NPoole/PSA_Oxygen_Concentrator/README.md

# PSA_Oxygen_Concentrator
An Oxikit-style Pressure Swing Adsorption Oxygen concentrator

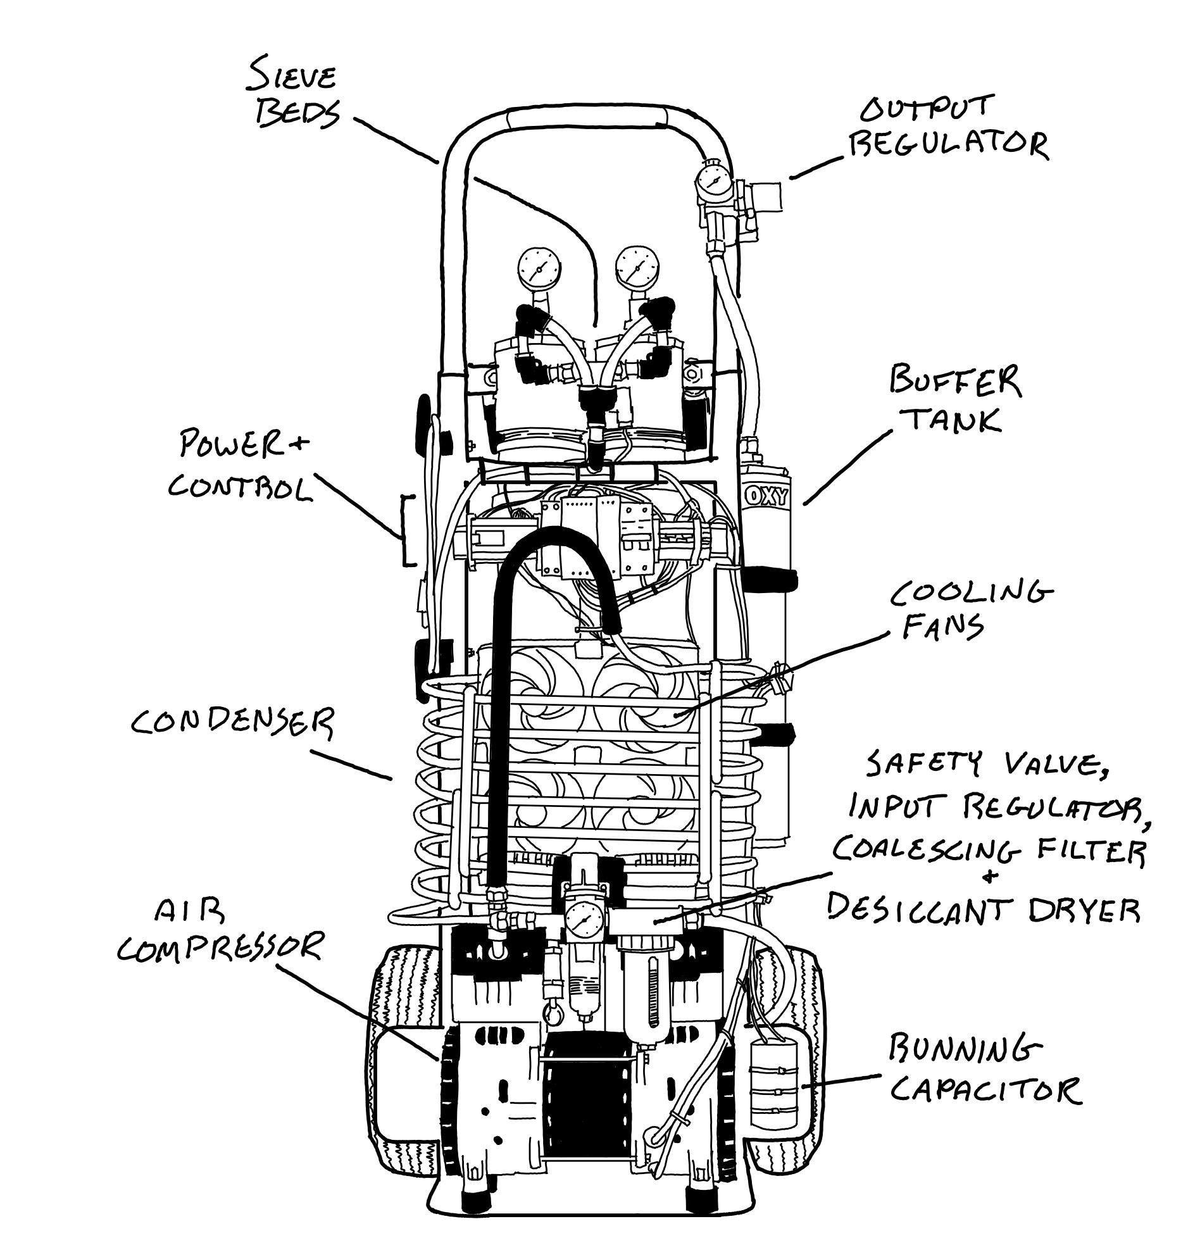
[picture p1: Photos/Illustration.png]
Complete System Illustration
