NPoole/PSA_Oxygen_Concentrator/Photos/Complete_Front.jpg

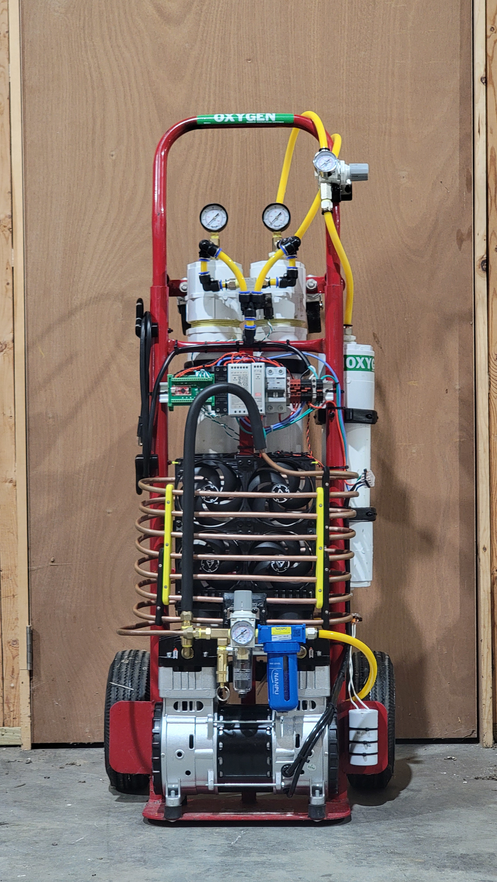
Photos/Complete_Front.jpg
