NPoole/PSA_Oxygen_Concentrator/Photos/Complete_Rear.jpg

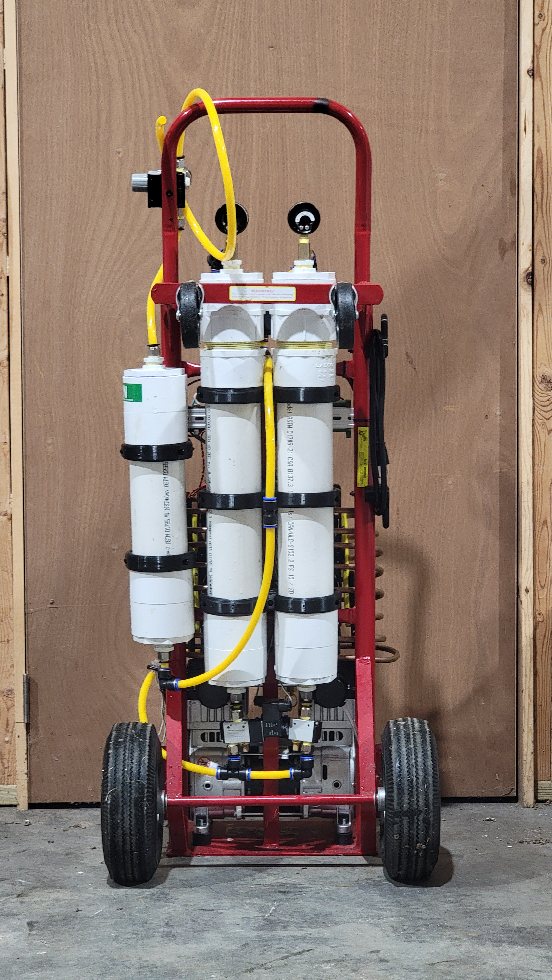
Photos/Complete_Rear.jpg
