NPoole/PSA_Oxygen_Concentrator/Photos/Complete_Side.jpg

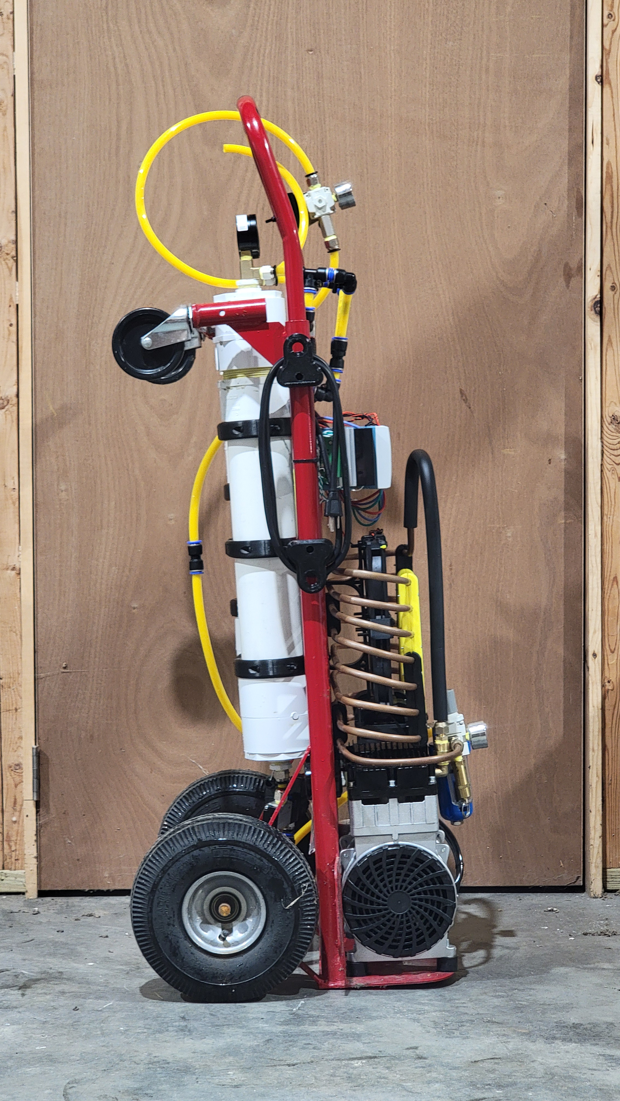
Photos/Complete_Side.jpg
