NPoole/PSA_Oxygen_Concentrator/CAD/STEP/Input Regulator Mount.step

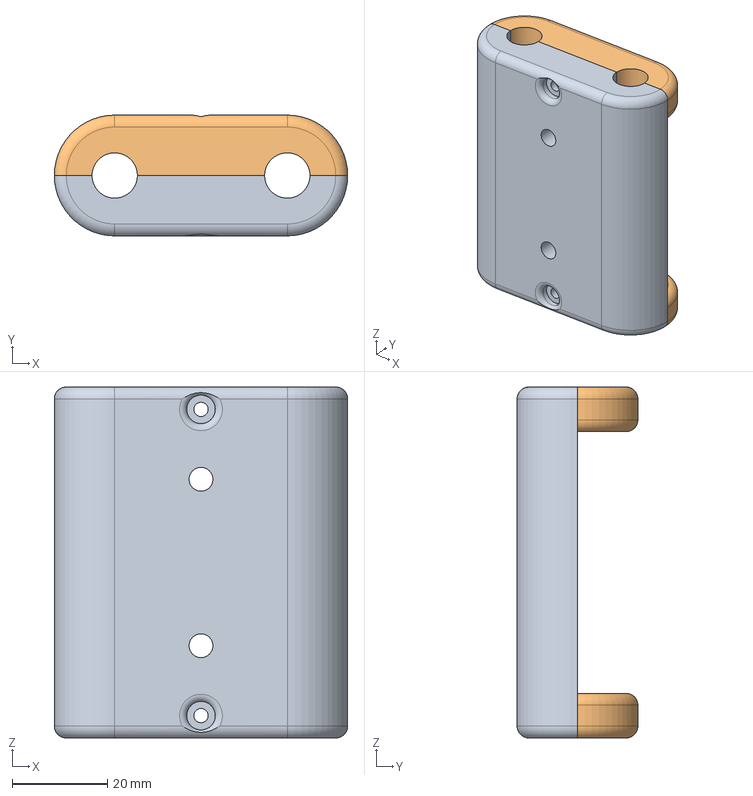
[picture p5: CAD file, 2024-06-01]
CAD/STEP/Input Regulator Mount.step
61.7 x 25.4 x 73.8 mm
