NPoole/PSA_Oxygen_Concentrator/CAD/STL/Hourmeter Mount.stl

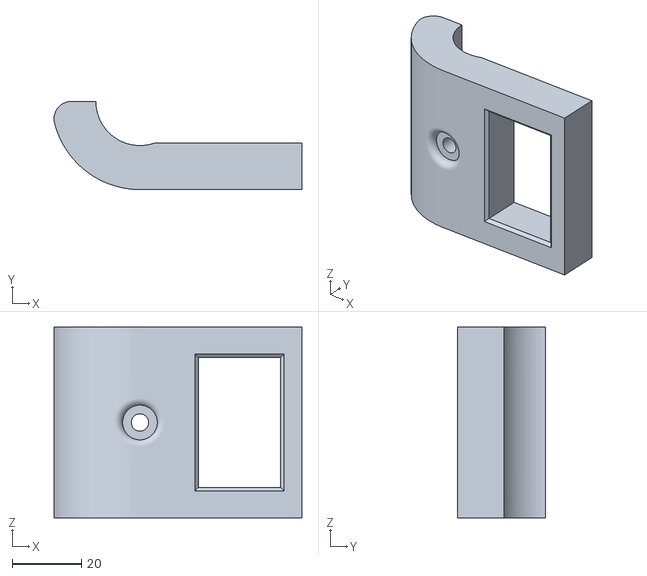
[picture p6: CAD file, 2024-06-11]
CAD/STL/Hourmeter Mount.stl
71.5 x 25.4 x 55.0
