NPoole/PSA_Oxygen_Concentrator/CAD/STEP/Coil Support Small.step

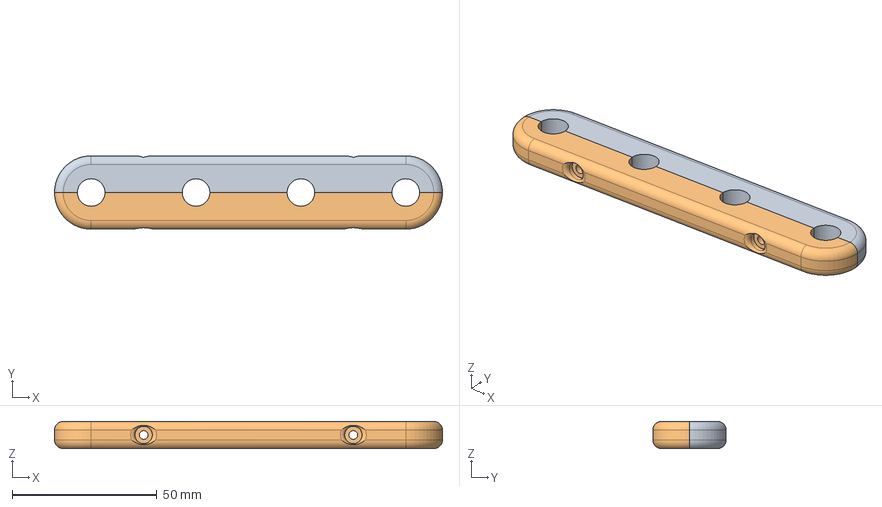
[picture p7: CAD file, 2024-06-01]
CAD/STEP/Coil Support Small.step
134.3 x 25.4 x 9.40 mm
