NPoole/PSA_Oxygen_Concentrator/CAD/STL/Cooling Fan Connector A.stl

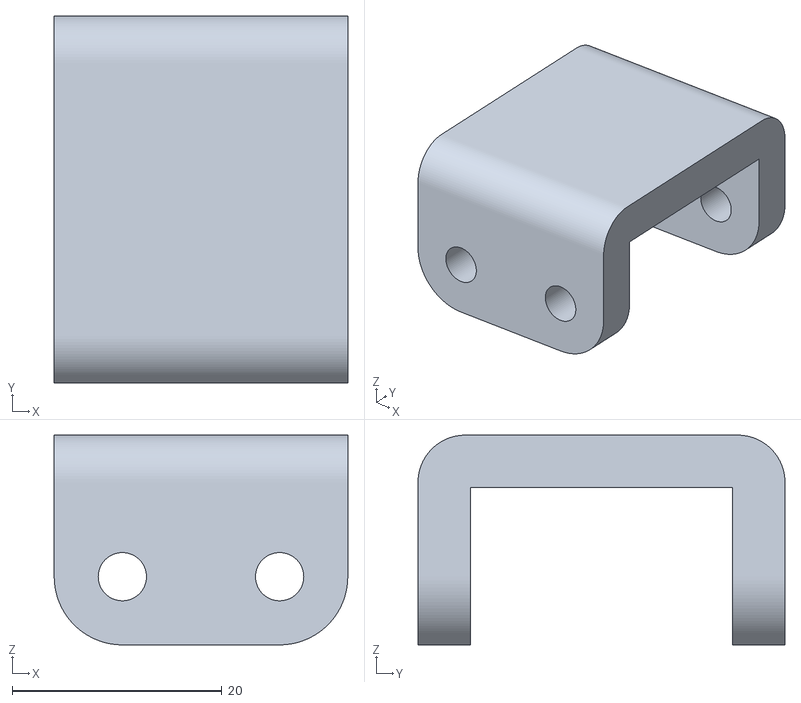
[picture p8: CAD file, 2024-06-01]
CAD/STL/Cooling Fan Connector A.stl
28.0 x 35.0 x 20.0
