NPoole/PSA_Oxygen_Concentrator/CAD/STEP/1_6mm orifice.step

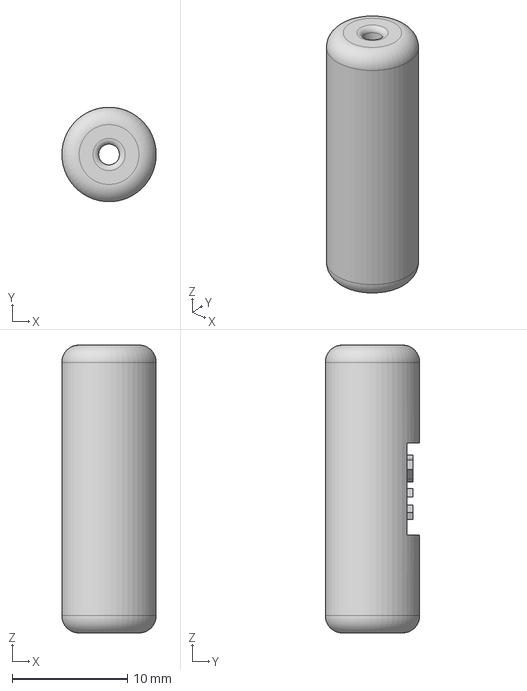
[picture p9: CAD file, 2024-06-01]
CAD/STEP/1_6mm orifice.step
8.19 x 8.20 x 25.0 mm
