NPoole/PSA_Oxygen_Concentrator/CAD/STL/Sieve Bed Piston.stl

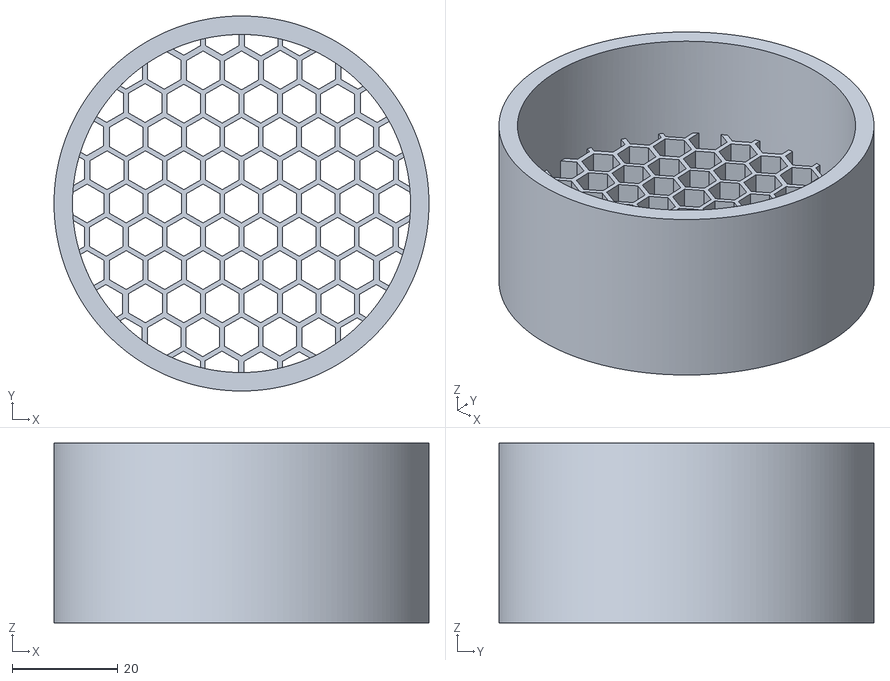
[picture p10: CAD file, 2024-06-01]
CAD/STL/Sieve Bed Piston.stl
71.0 x 71.0 x 34.0
