NPoole/PSA_Oxygen_Concentrator/CAD/STEP/Coil Support Large.step

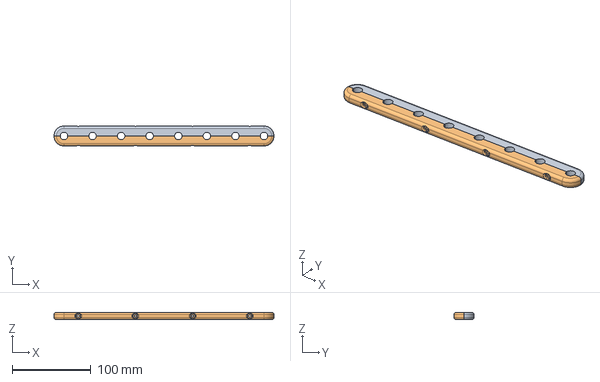
[picture p11: CAD file, 2024-06-01]
CAD/STEP/Coil Support Large.step
279.4 x 25.4 x 9.40 mm
