NPoole/PSA_Oxygen_Concentrator/CAD/STL/Cooling Fan Connector C.stl

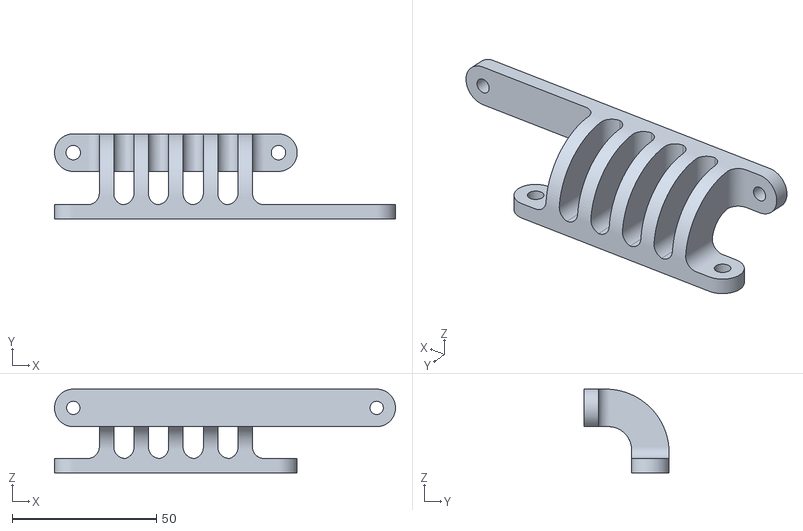
[picture p12: CAD file, 2024-06-01]
CAD/STL/Cooling Fan Connector C.stl
118.0 x 29.5 x 29.0
