NPoole/PSA_Oxygen_Concentrator/CAD/STEP/DIN Rail Mount.step

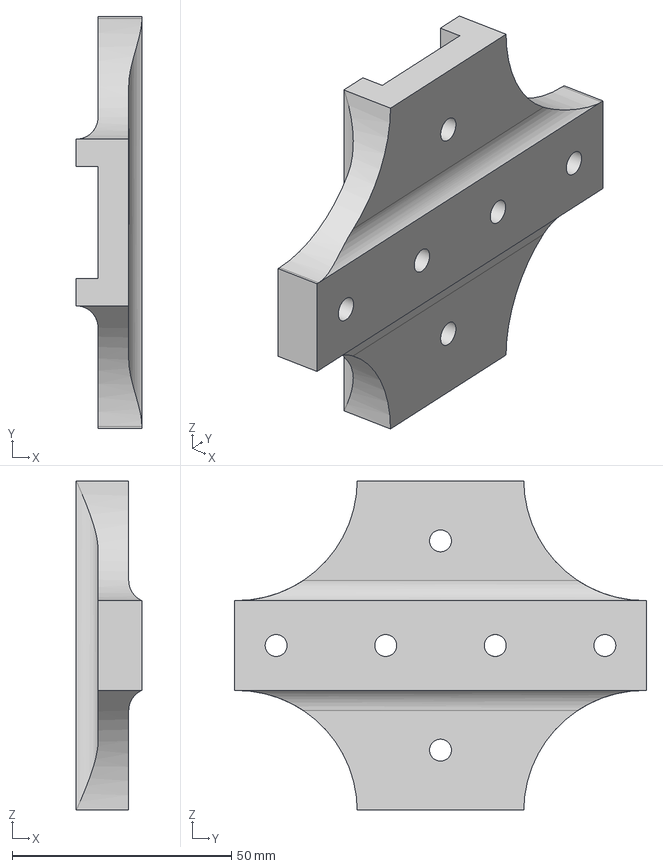
[picture p13: CAD file, 2024-06-01]
CAD/STEP/DIN Rail Mount.step
15.0 x 94.0 x 75.0 mm
