NPoole/PSA_Oxygen_Concentrator/CAD/STL/Input Regulator Mount Part B.stl

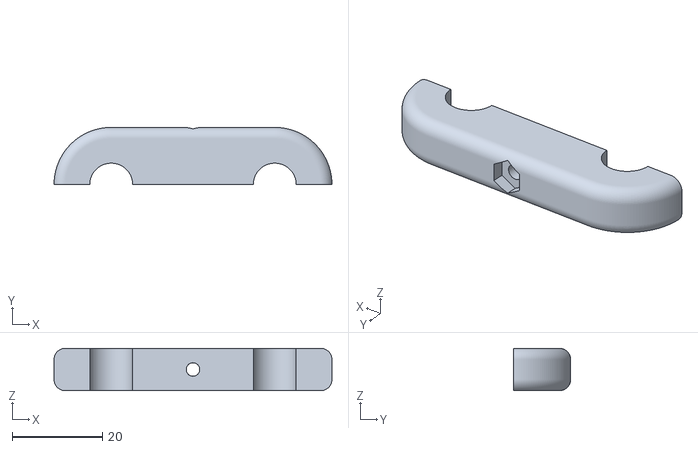
[picture p14: CAD file, 2024-06-01]
CAD/STL/Input Regulator Mount Part B.stl
61.7 x 12.7 x 9.40
