NPoole/PSA_Oxygen_Concentrator/CAD/STEP/Coil Mount.step

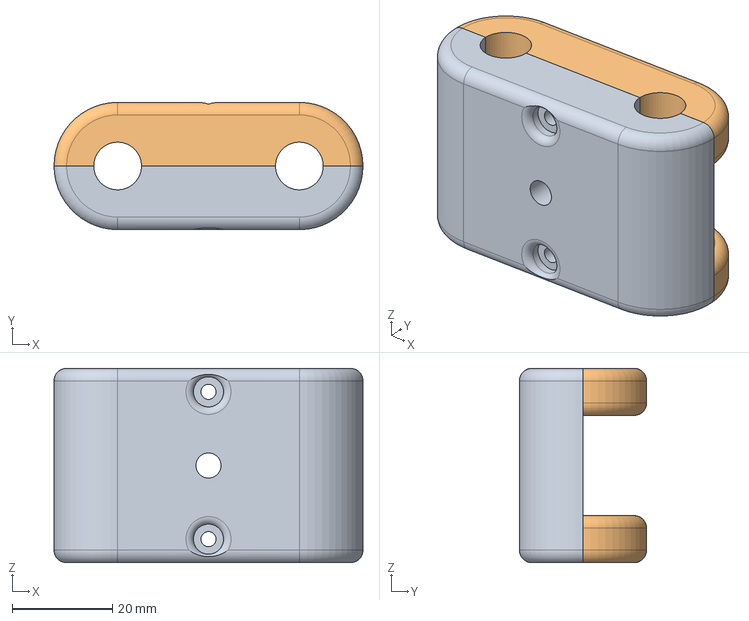
[picture p15: CAD file, 2024-06-01]
CAD/STEP/Coil Mount.step
61.7 x 25.4 x 38.8 mm
