NPoole/PSA_Oxygen_Concentrator/CAD/STEP/Output Regulator Mount.step

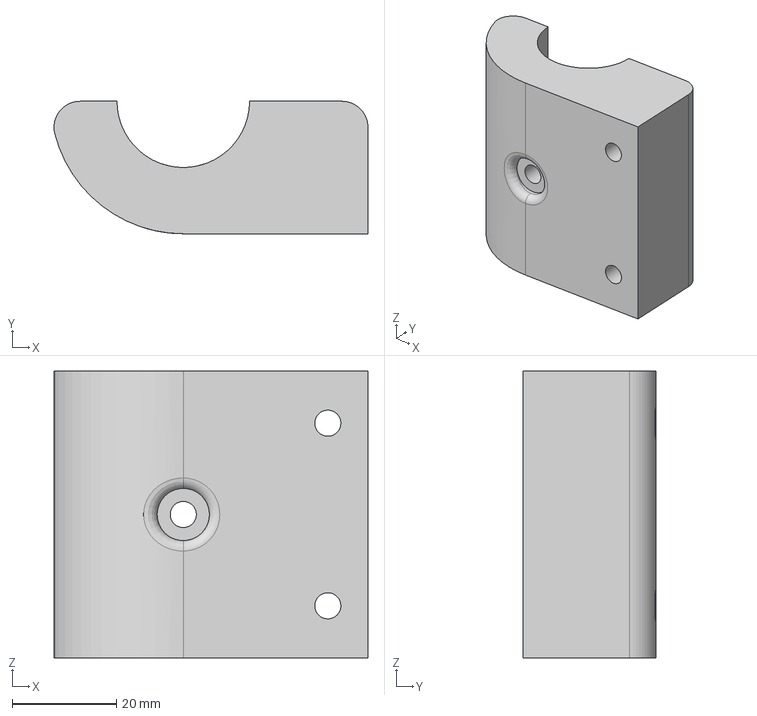
[picture p16: CAD file, 2024-06-01]
CAD/STEP/Output Regulator Mount.step
60.2 x 25.4 x 55.0 mm
