NPoole/PSA_Oxygen_Concentrator/CAD/STL/Coil Support Part B (SML).stl

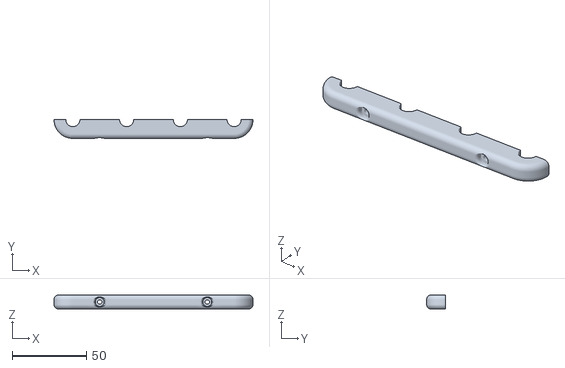
[picture p17: CAD file, 2024-06-01]
CAD/STL/Coil Support Part B (SML).stl
134.3 x 12.7 x 9.40
