NPoole/PSA_Oxygen_Concentrator/CAD/STEP/Sieve Bed Parts.step

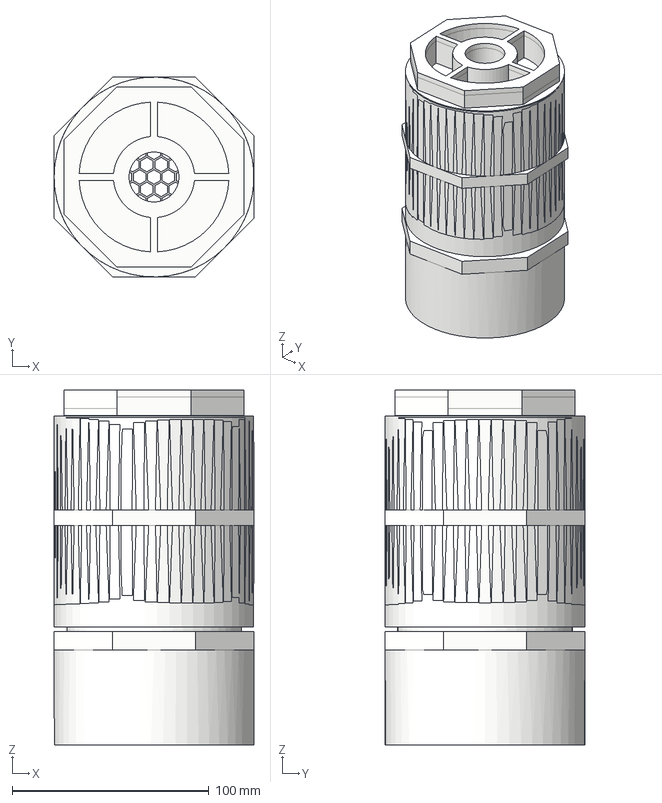
[picture p18: CAD file, 2024-06-01]
CAD/STEP/Sieve Bed Parts.step
101.6 x 101.6 x 180.5 mm
