NPoole/PSA_Oxygen_Concentrator/CAD/STL/Sieve Mount Part B.stl

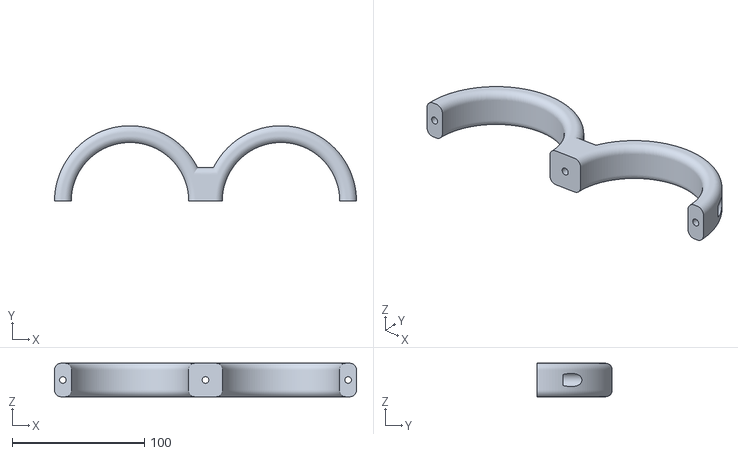
[picture p19: CAD file, 2024-06-01]
CAD/STL/Sieve Mount Part B.stl
228.6 x 57.1 x 25.4
