NPoole/PSA_Oxygen_Concentrator/CAD/STEP/Sieve Mount.step

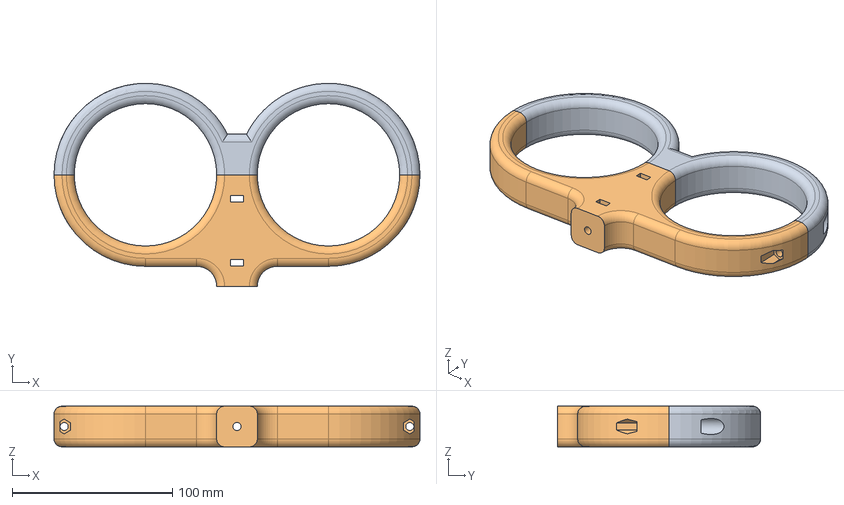
[picture p20: CAD file, 2024-06-01]
CAD/STEP/Sieve Mount.step
228.6 x 127.0 x 25.4 mm
