NPoole/PSA_Oxygen_Concentrator/CAD/STL/Cooling Fan Connector B.stl

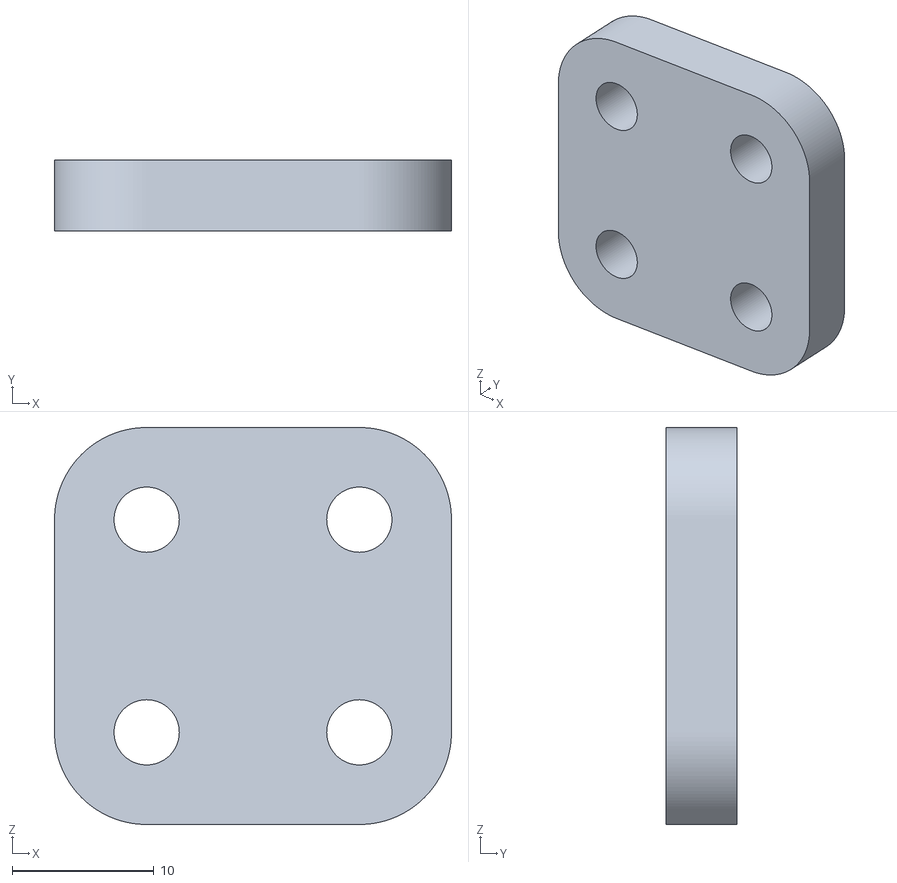
[picture p21: CAD file, 2024-06-01]
CAD/STL/Cooling Fan Connector B.stl
28.0 x 5.00 x 28.0
