NPoole/PSA_Oxygen_Concentrator/CAD/STEP/Buffer Mount.step

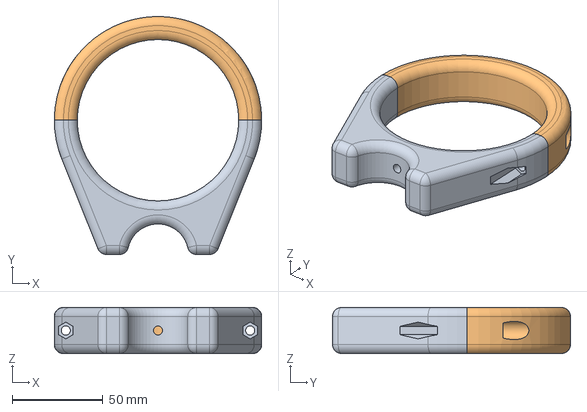
[picture p22: CAD file, 2024-06-01]
CAD/STEP/Buffer Mount.step
114.3 x 131.1 x 25.4 mm
