NPoole/PSA_Oxygen_Concentrator/CAD/STL/Coil Support Part B (LRG).stl

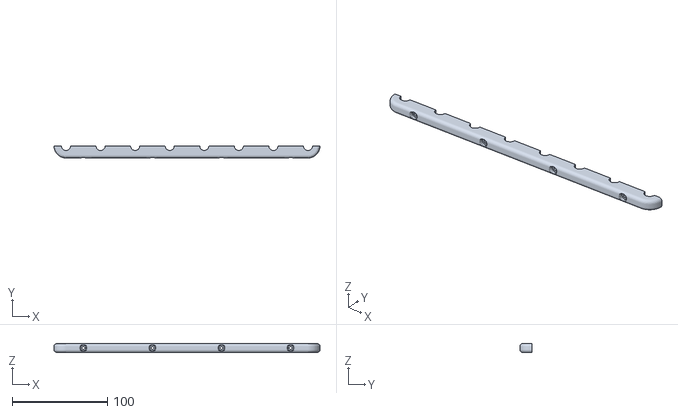
[picture p23: CAD file, 2024-06-01]
CAD/STL/Coil Support Part B (LRG).stl
279.4 x 12.7 x 9.40
