NPoole/PSA_Oxygen_Concentrator/CAD/STEP/Cord Keeper.step

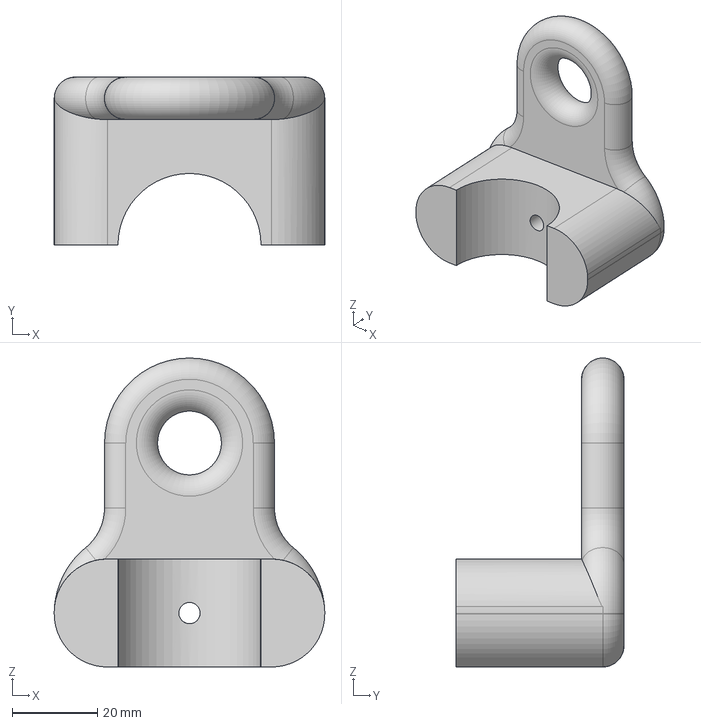
[picture p24: CAD file, 2024-06-01]
CAD/STEP/Cord Keeper.step
63.7 x 39.5 x 72.7 mm
