NPoole/PSA_Oxygen_Concentrator/CAD/STL/Buffer Mount Part A.stl

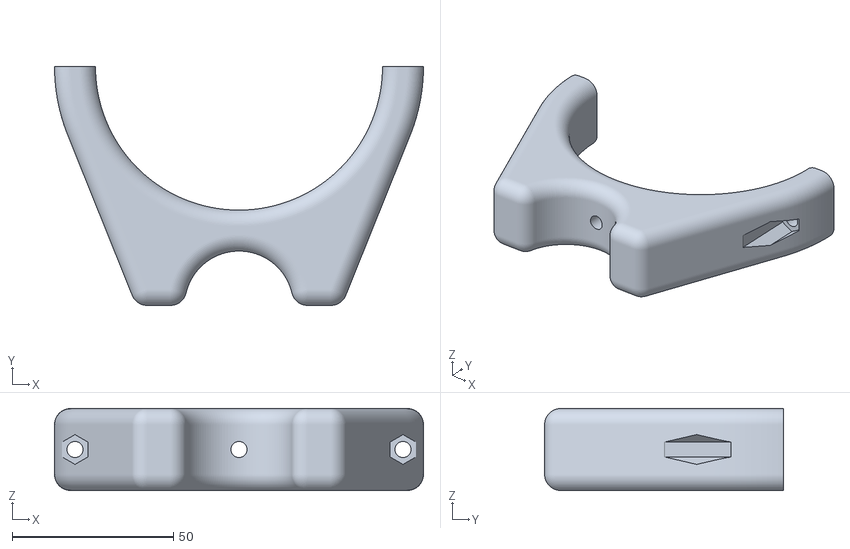
[picture p25: CAD file, 2024-06-01]
CAD/STL/Buffer Mount Part A.stl
114.3 x 74.0 x 25.4
