NPoole/PSA_Oxygen_Concentrator/CAD/STL/Input Regulator Mount Part A.stl

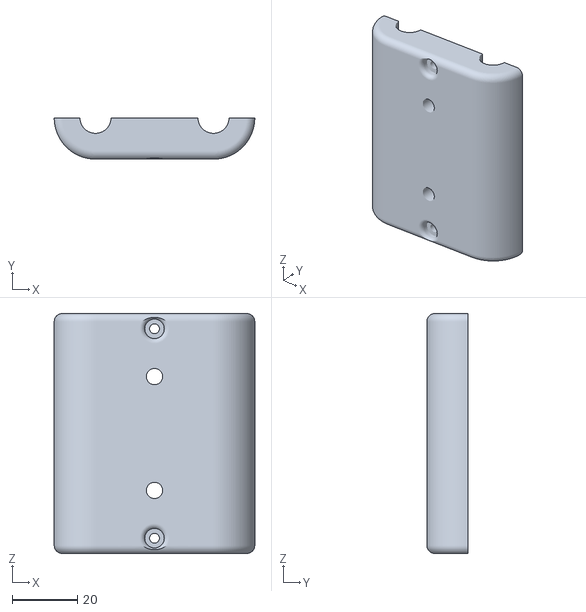
[picture p26: CAD file, 2024-06-01]
CAD/STL/Input Regulator Mount Part A.stl
61.7 x 12.7 x 73.8
