NPoole/PSA_Oxygen_Concentrator/CAD/STL/Sieve Bed Mesh Retainer.stl

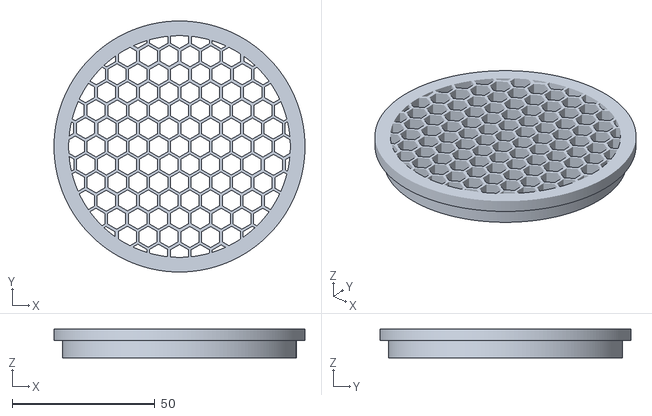
[picture p27: CAD file, 2024-06-01]
CAD/STL/Sieve Bed Mesh Retainer.stl
88.0 x 88.0 x 10.0
