NPoole/PSA_Oxygen_Concentrator/CAD/STL/Sieve Bed Spring Seat.stl

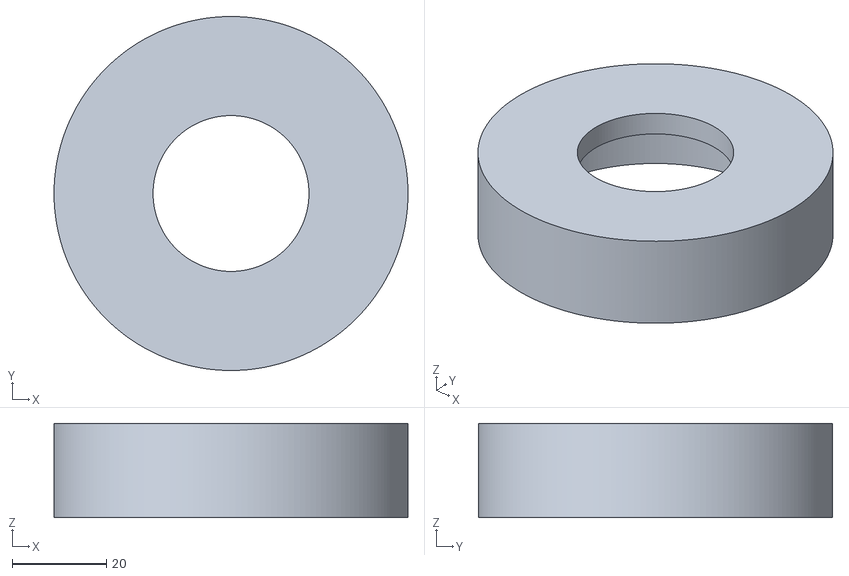
[picture p28: CAD file, 2024-06-01]
CAD/STL/Sieve Bed Spring Seat.stl
75.0 x 75.0 x 20.0
