NPoole/PSA_Oxygen_Concentrator/CAD/STL/Sieve Mount Part A.stl

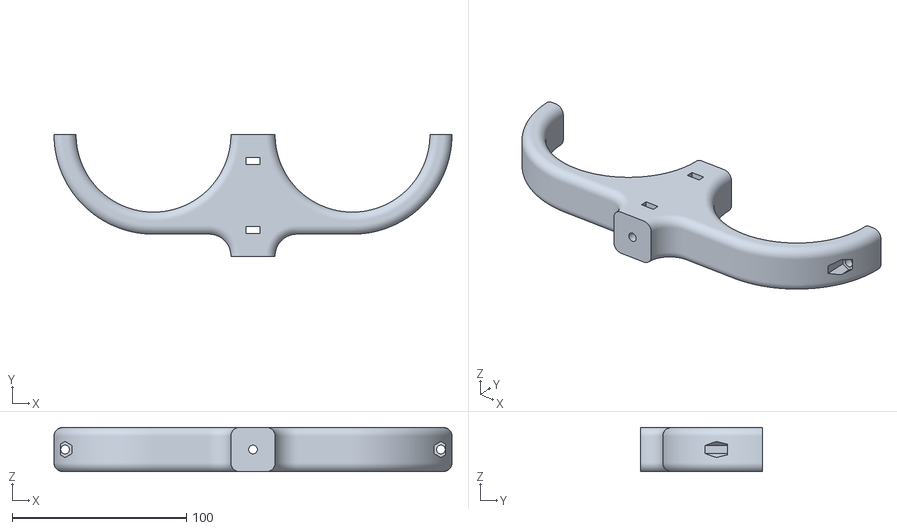
[picture p29: CAD file, 2024-06-01]
CAD/STL/Sieve Mount Part A.stl
228.6 x 69.8 x 25.4
