NPoole/PSA_Oxygen_Concentrator/CAD/STL/Cooling Fan Mount.stl

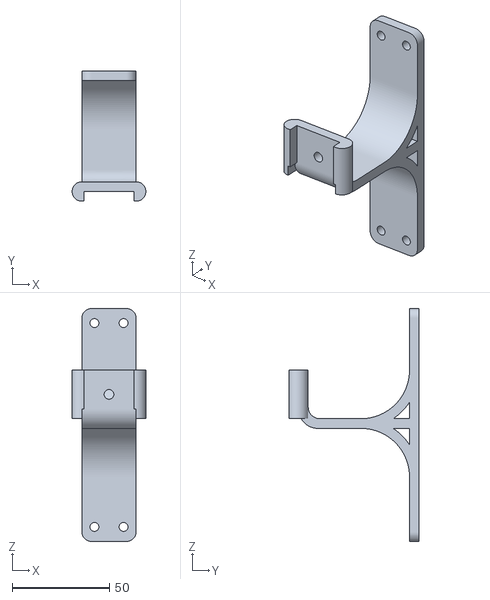
[picture p30: CAD file, 2024-06-01]
CAD/STL/Cooling Fan Mount.stl
38.0 x 67.2 x 120.0
