NPoole/PSA_Oxygen_Concentrator/CAD/STL/Buffer Mount Part B.stl

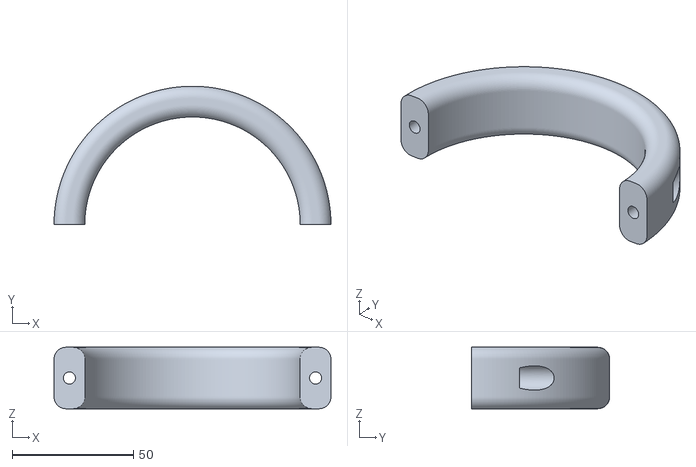
[picture p31: CAD file, 2024-06-01]
CAD/STL/Buffer Mount Part B.stl
114.3 x 57.2 x 25.4
