NPoole/PSA_Oxygen_Concentrator/CAD/STL/Coil Mount Part A.stl

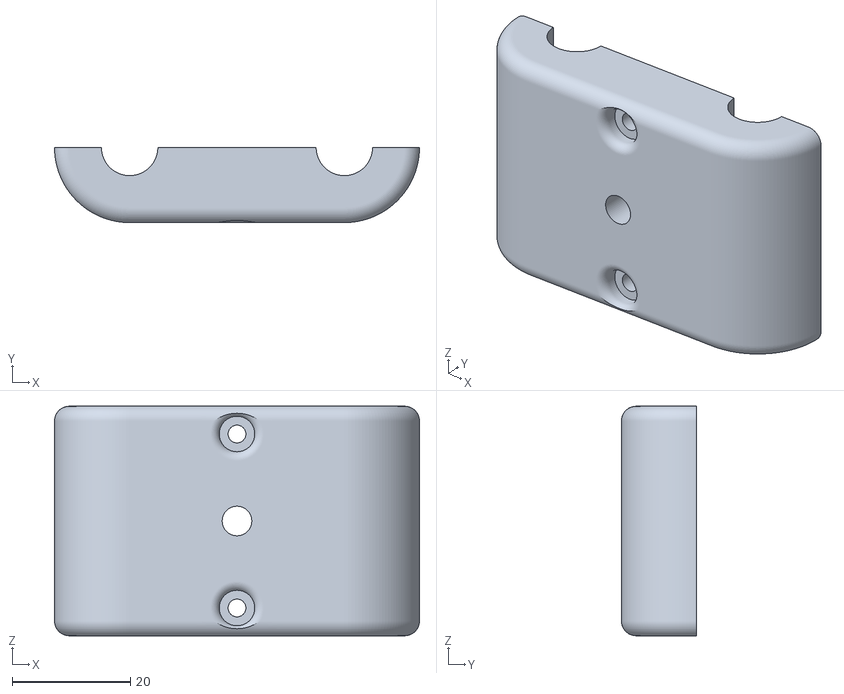
[picture p32: CAD file, 2024-06-01]
CAD/STL/Coil Mount Part A.stl
61.7 x 12.7 x 38.8
