NPoole/PSA_Oxygen_Concentrator/(list of files, cad)

Other CAD files:
CAD/STL/Cooling Fan Connector D.stl
CAD/STL/Coil Support Part A (SML).stl
CAD/STL/Coil Support Part A (LRG).stl
CAD/STL/1_6mm orifice.stl
CAD/STL/Cord Keeper.stl
CAD/STL/DIN Rail Mount.stl
CAD/STL/Output Regulator Mount.stl
