NPoole/PSA_Oxygen_Concentrator/Photos/Cooling Assembly.jpg

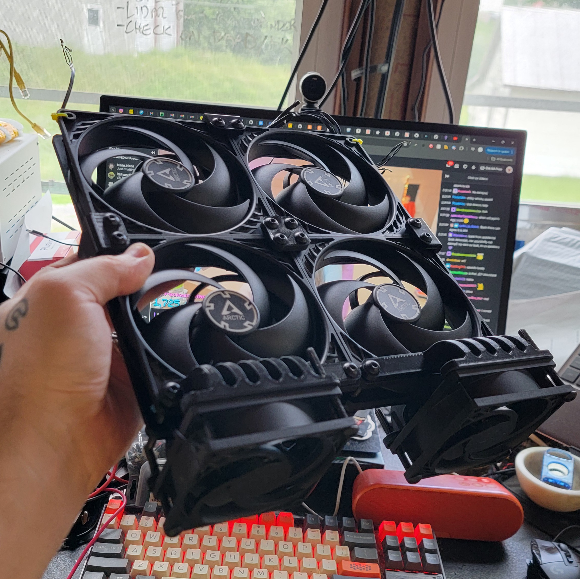
Photos/Cooling Assembly.jpg
