NPoole/PSA_Oxygen_Concentrator/Photos/Burn Test.jpg

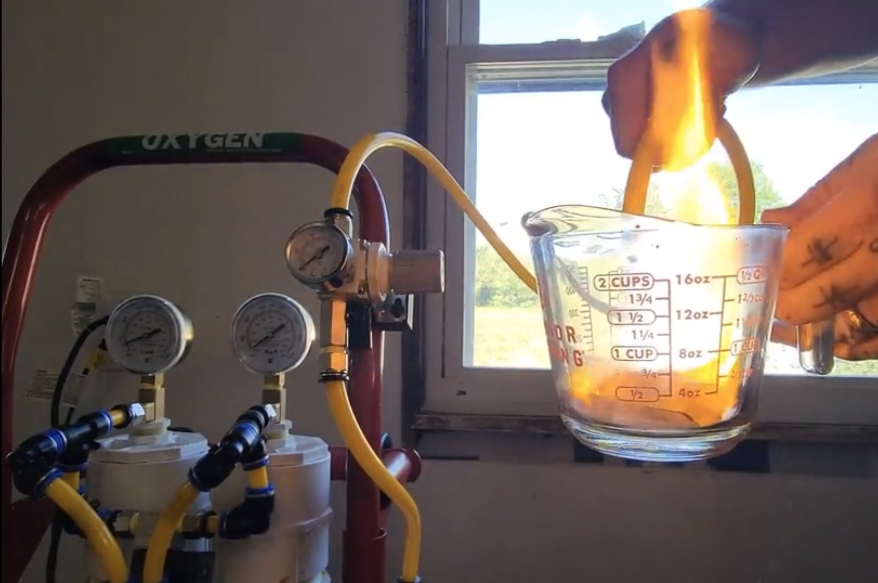
Photos/Burn Test.jpg
