NPoole/PSA_Oxygen_Concentrator/Project Costing List.pdf

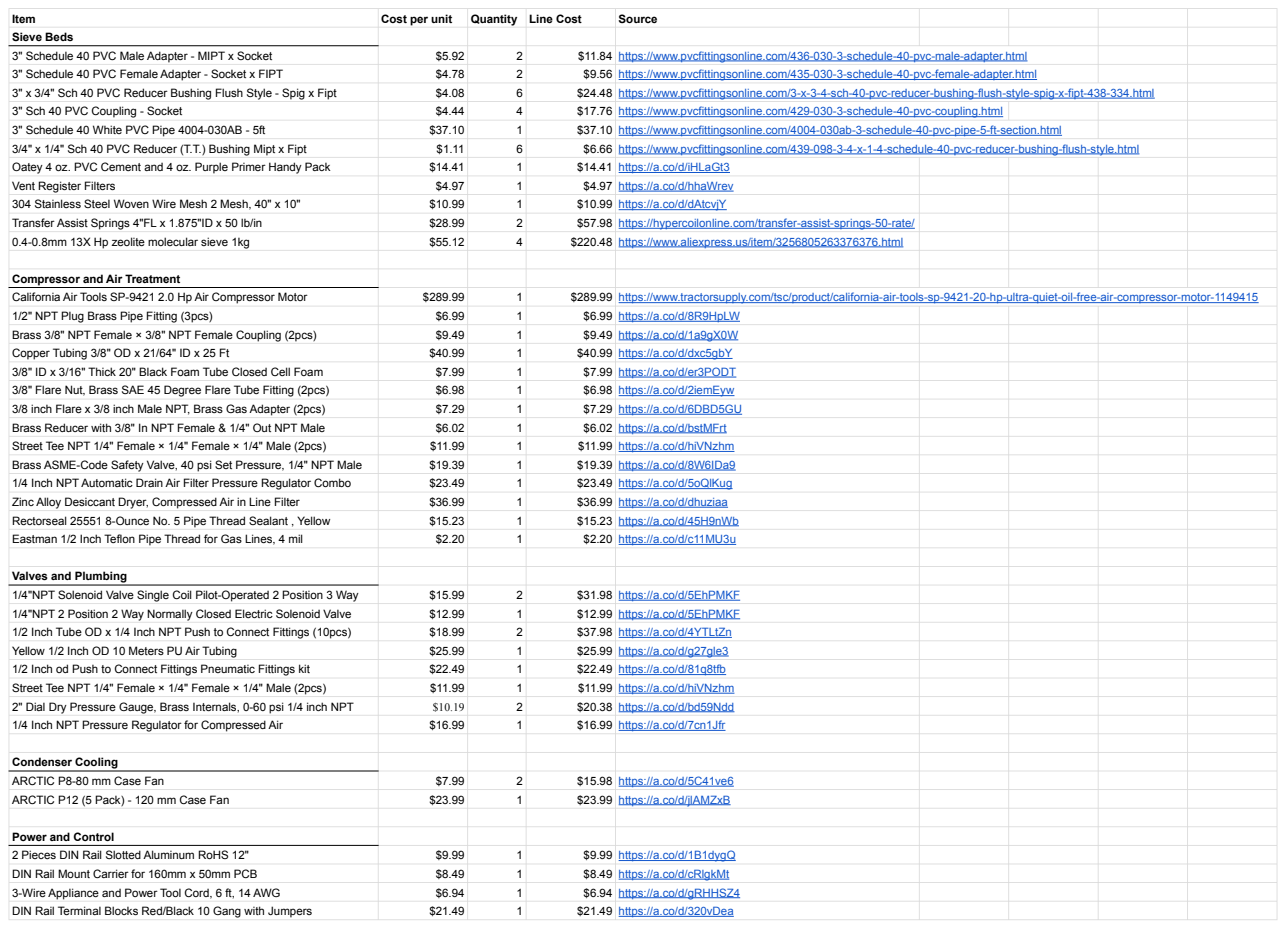
[picture p35: page 1]
Item; Cost per unit; Quantity Line Cost; Source; Sieve Beds; 3" Schedule 40 PVC Male Adapter - MIPT x Socket; $11.84 https://www.pvcfittingsonline.com/436-030-3-schedule-40-pvc-male-adapter.html; 3" Schedule 40 PVC Female Adapter - Socket x FIPT; $9.56 https://www.pvcfittingsonline.com/435-030-3-schedule-40-pvc-female-adapter.html; 3" x 3/4" Sch 40 PVC Reducer Bushing Flush Style - Spig x Fipt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

Compressor and Air Treatment

Valves and Plumbing

Power and Control

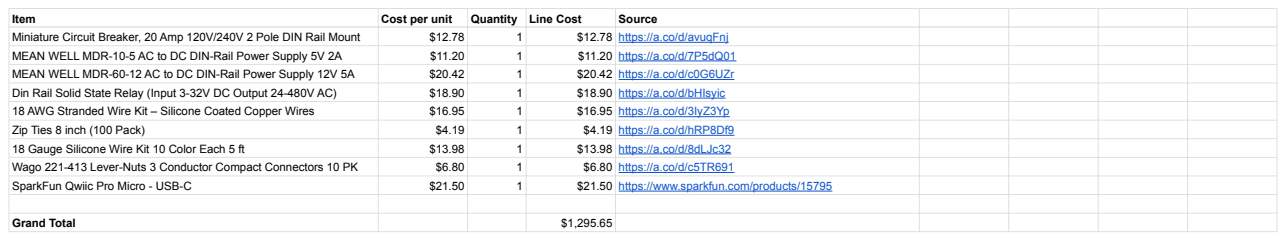
[picture p36: page 2]
Item; Cost per unit; Quantity; Line Cost; Source; Miniature Circuit Breaker, 20 Amp 120V/240V 2 Pole DIN Rail Mount; $12.78 https://a.co/d/avuqFnj; MEAN WELL MDR-10-5 AC to DC DIN-Rail Power Supply 5V 2A; $11.20 https://a.co/d/7P5dQ01; MEAN WELL MDR-60-12 AC to DC DIN-Rail Power Supply 12V 5A; $20.42 https://a.co/d/c0G6UZr; Din Rail Solid State Relay (Input 3-32V DC Output 24-480V AC); $18.90 https://a.co/d/bHIsyic; 18 AWG Stranded Wire Kit – Silicone Coated Copper Wires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
