NPoole/PSA_Oxygen_Concentrator/Controller/Hardware/PSA_Controller/Schematic.pdf

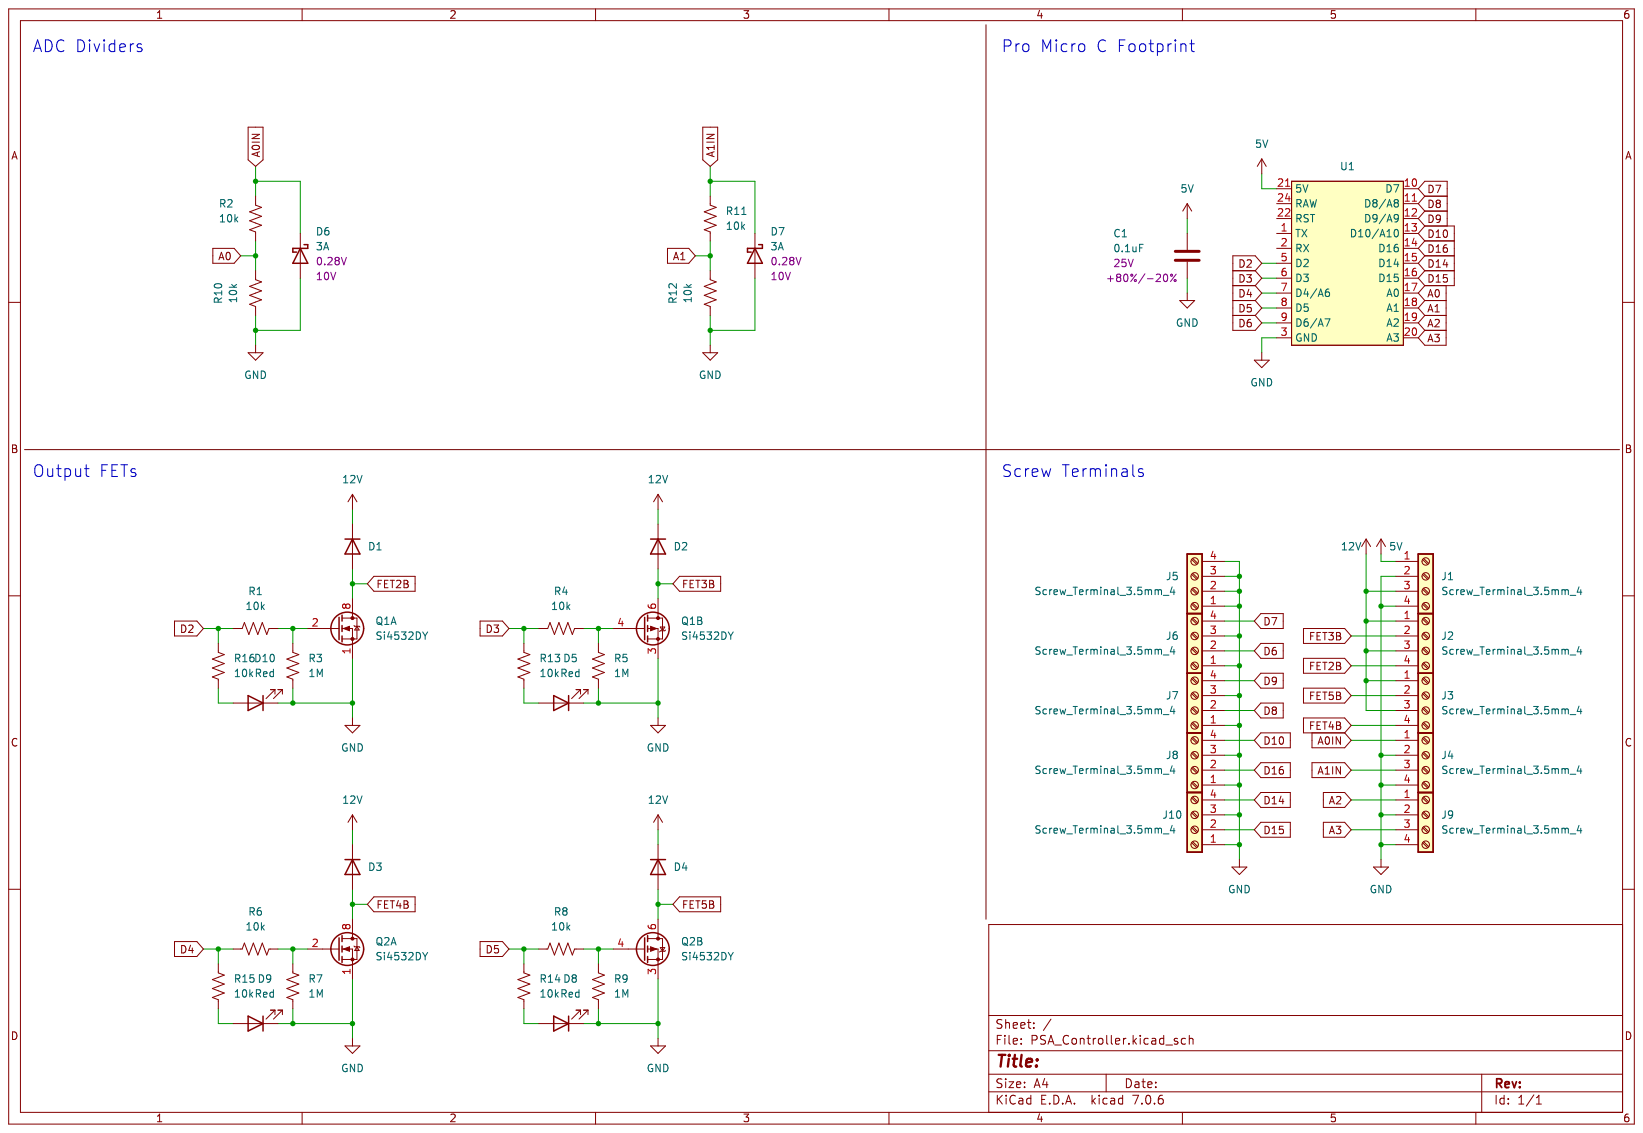
[picture p37: page 1]
