NPoole/PSA_Oxygen_Concentrator/Controller/Hardware/PSA_Controller/PSA_Controller.kicad_pcb

## KiCad design Controller/Hardware/PSA_Controller/PSA_Controller.kicad_pcb (2024-06-01)

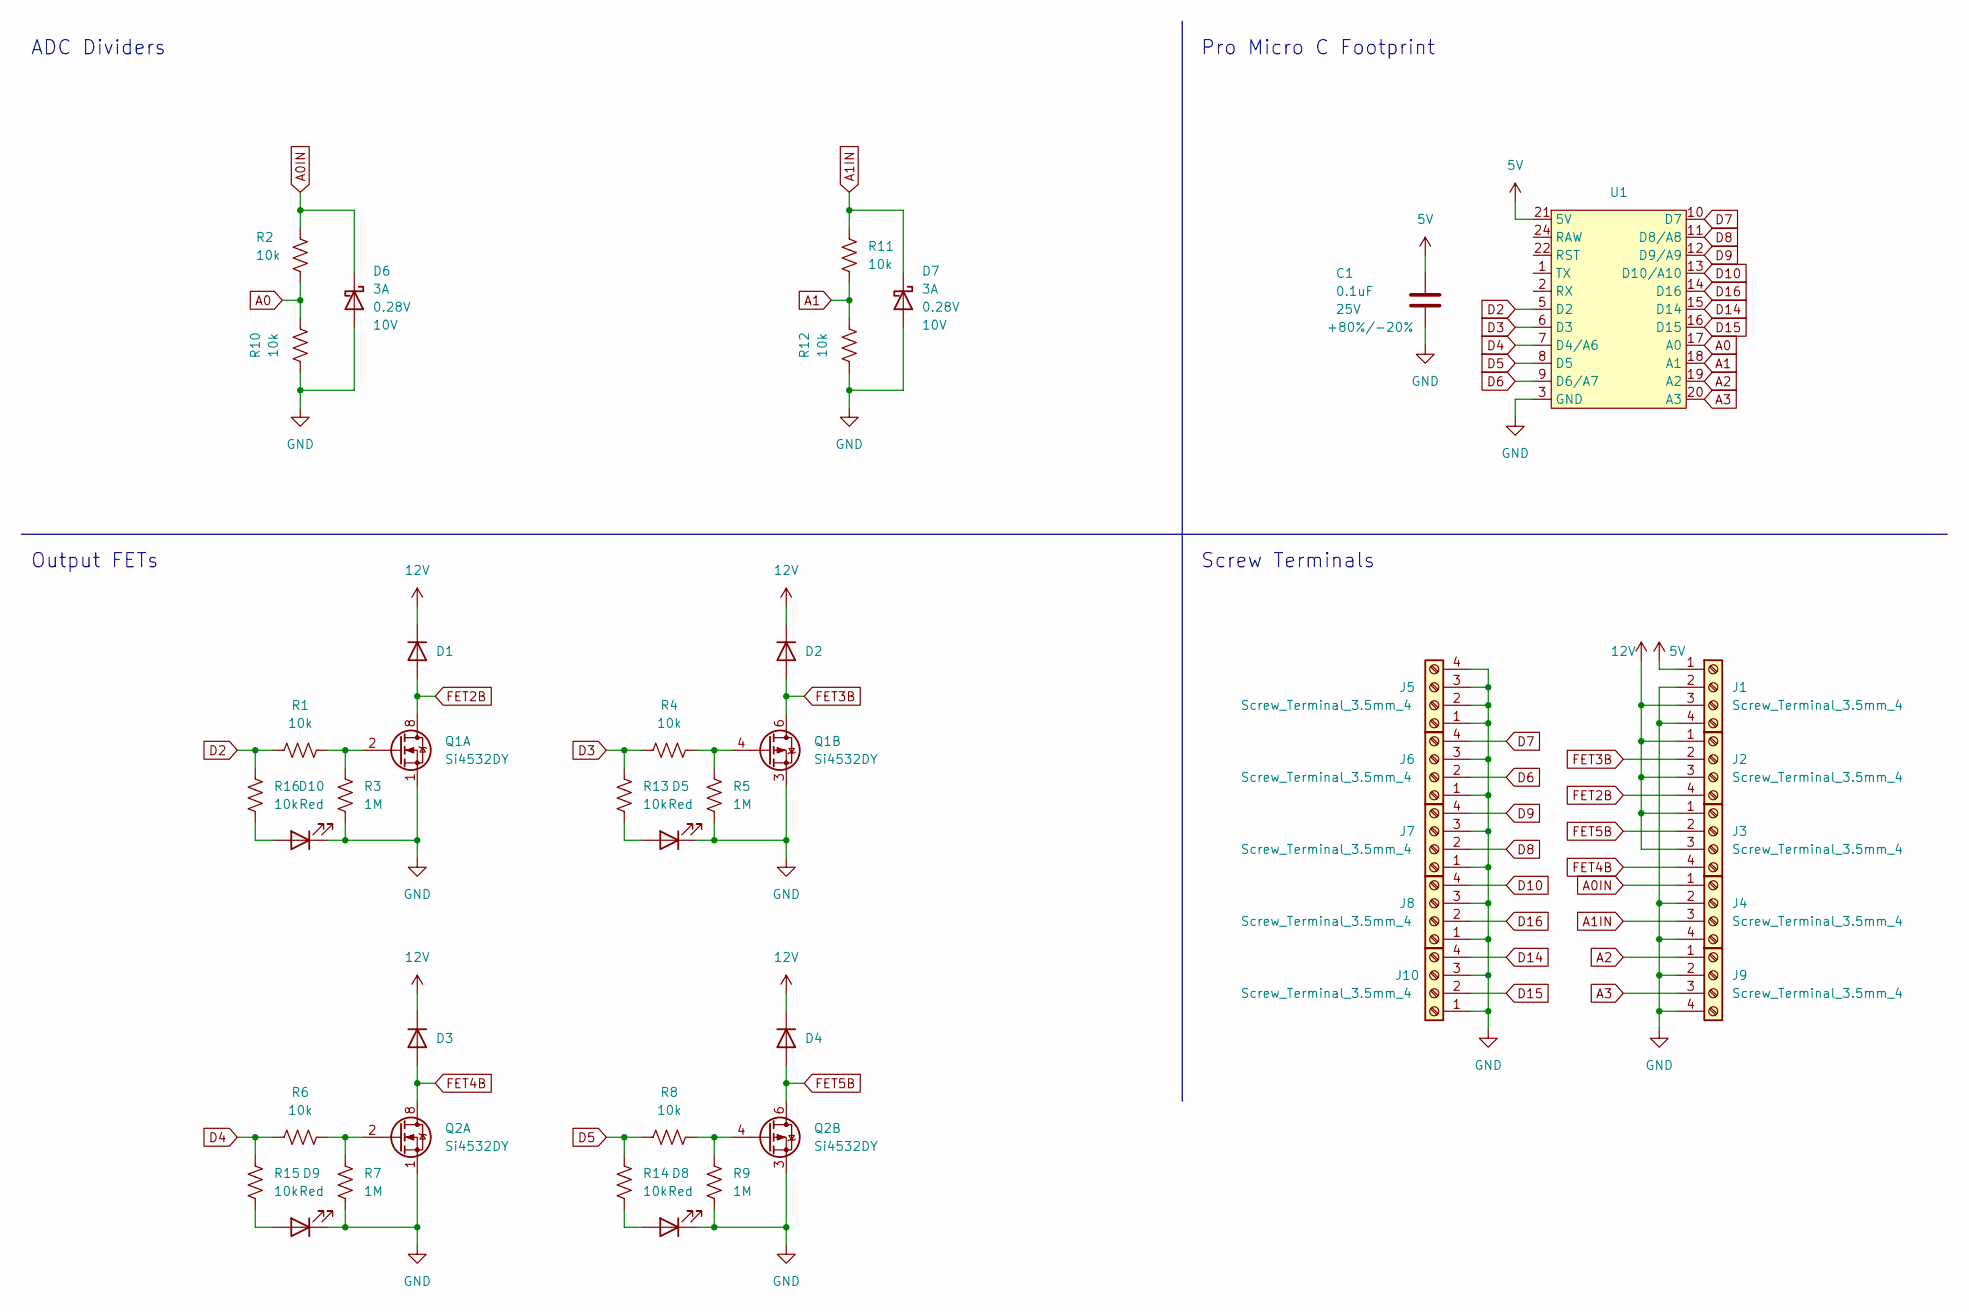
[picture p38: schematic PSA_Controller.kicad_sch]

Parts:
C1: 0.1uF; C_0603_1608Metric; Voltage 25V; Tolerance +80%/-20%
D1, D2, D3, D4: SOD-323
D5, D8, D9, D10: Red; LED_0603_1608Metric
D6, D7: 3A; SOD-323
J1, J2, J3, J4, J5, J6, J7, J8, J9, J10: Screw_Terminal_3.5mm_4; SCREWTERMINAL-3.5MM-4
Q1, Q2: Si4532DY; SOIC-8_3.9x4.9mm_P1.27mm
R1, R2, R4, R6, R8, R10, R11, R12, R13, R14, R15, R16: 10k; R_0603_1608Metric
R3, R5, R7, R9: 1M; R_0603_1608Metric
U1: P

Connections:
5V: C1.1, J1.1, U1.21 (5V)
12V: D1.C, D2.C, D3.C, D4.C, J1.3, J2.1, J2.3, J3.1, J3.3
A0: R2.2, R10.2, U1.17 (A0)
A0IN: D6.C, J4.1, R2.1
A1: R11.1, R12.2, U1.18 (A1)
A1IN: D7.C, J4.3, R11.2
A2: J9.1, U1.19 (A2)
A3: J9.3, U1.20 (A3)
D2: R1.1, R16.2, U1.5 (D2)
D3: R4.1, R13.2, U1.6 (D3)
D4: R6.1, R15.2, U1.7 (D4/A6)
D5: R8.1, R14.2, U1.8 (D5)
D6: J6.2, U1.9 (D6/A7)
D7: J6.4, U1.10 (D7)
D8: J7.2, U1.11 (D8/A8)
D9: J7.4, U1.12 (D9/A9)
D10: J8.4, U1.13 (D10/A10)
D14: J10.4, U1.15 (D14)
D15: J10.2, U1.16 (D15)
D16: J8.2, U1.14 (D16)
FET2B: D1.A, J2.4, Q1.7 (D), Q1.8 (D)
FET3B: D2.A, J2.2, Q1.5 (D), Q1.6 (D)
FET4B: D3.A, J3.4, Q2.7 (D), Q2.8 (D)
FET5B: D4.A, J3.2, Q2.5 (D), Q2.6 (D)
GND: C1.2, D5.1 (K), D6.A, D7.A, D8.1 (K), D9.1 (K), D10.1 (K), J1.2, J1.4, J4.2, J4.4, J5.1, J5.2, J5.3, J5.4, J6.1, J6.3, J7.1, J7.3, J8.1, J8.3, J9.2, J9.4, J10.1, J10.3, Q1.1 (S), Q1.3 (1), Q2.1 (S), Q2.3 (1), R3.2, R5.2, R7.2, R9.2, R10.1, R12.1, U1.3 (GND), U1.4 (GND), U1.23 (GND)
unnamed: D5.2 (A), R13.1
unnamed: D8.2 (A), R14.1
unnamed: D9.2 (A), R15.1
unnamed: D10.2 (A), R16.1
unnamed: Q1.2 (G), R1.2, R3.1
unnamed: Q1.4 (G), R4.2, R5.1
unnamed: Q2.2 (G), R6.2, R7.1
unnamed: Q2.4 (G), R8.2, R9.1

Notes on the sheet:
Pro Micro C Footprint
ADC Dividers
Screw Terminals
Output FETs

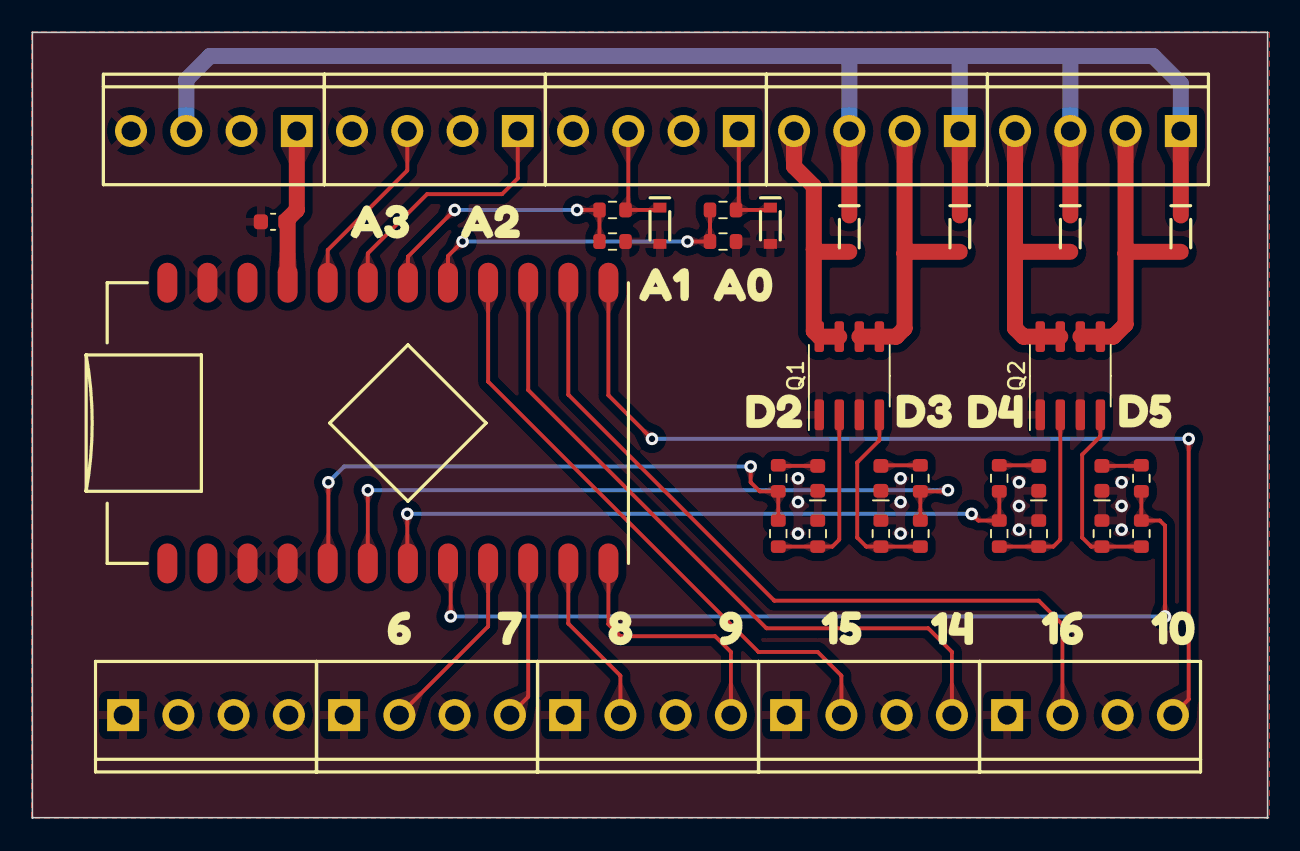
[picture p39: board PSA_Controller.kicad_pcb from above]

Board: 2 copper layers, 78.2 x 49.8 mm, 56 parts (0 on the bottom side), 33 nets.

Other parts of the board:
kibuzzard-65A2DED7: G***; kibuzzard-65A2DED7
kibuzzard-65A2DEE2: G***; kibuzzard-65A2DEE2
kibuzzard-65A2DF0B: G***; kibuzzard-65A2DF0B
kibuzzard-65A2DF03: G***; kibuzzard-65A2DF03
kibuzzard-65A2DF4A: G***; kibuzzard-65A2DF4A
kibuzzard-65A2DF5D: G***; kibuzzard-65A2DF5D
kibuzzard-65A2DF6F: G***; kibuzzard-65A2DF6F
kibuzzard-65A2DF9C: G***; kibuzzard-65A2DF9C
kibuzzard-65A2DF36: G***; kibuzzard-65A2DF36
kibuzzard-65A2DFAB: G***; kibuzzard-65A2DFAB
kibuzzard-65A2DFB3: G***; kibuzzard-65A2DFB3
kibuzzard-65A2DFBB: G***; kibuzzard-65A2DFBB
kibuzzard-65A2DFC2: G***; kibuzzard-65A2DFC2
kibuzzard-65A2DFD0: G***; kibuzzard-65A2DFD0
kibuzzard-65A2DFDA: G***; kibuzzard-65A2DFDA
kibuzzard-65A2DFE3: G***; kibuzzard-65A2DFE3
