NPoole/PSA_Oxygen_Concentrator/(commit log)

2024-06-01 Initial Upload
    [1_6mm orifice.step, 1_6mm orifice.stl, Buffer Mount Part A.stl, Buffer Mount Part B.stl, Buffer Mount.step, Coil Mount Part A.stl, Coil Mount Part B.stl, Coil Mount.step]
2024-06-11 Create Hourmeter Mount.stl
    [Hourmeter Mount.stl]
